Erriez/DualTDA7293PowerAmplifier/schematic/DualTDA7293PowerAmplifier.pdf

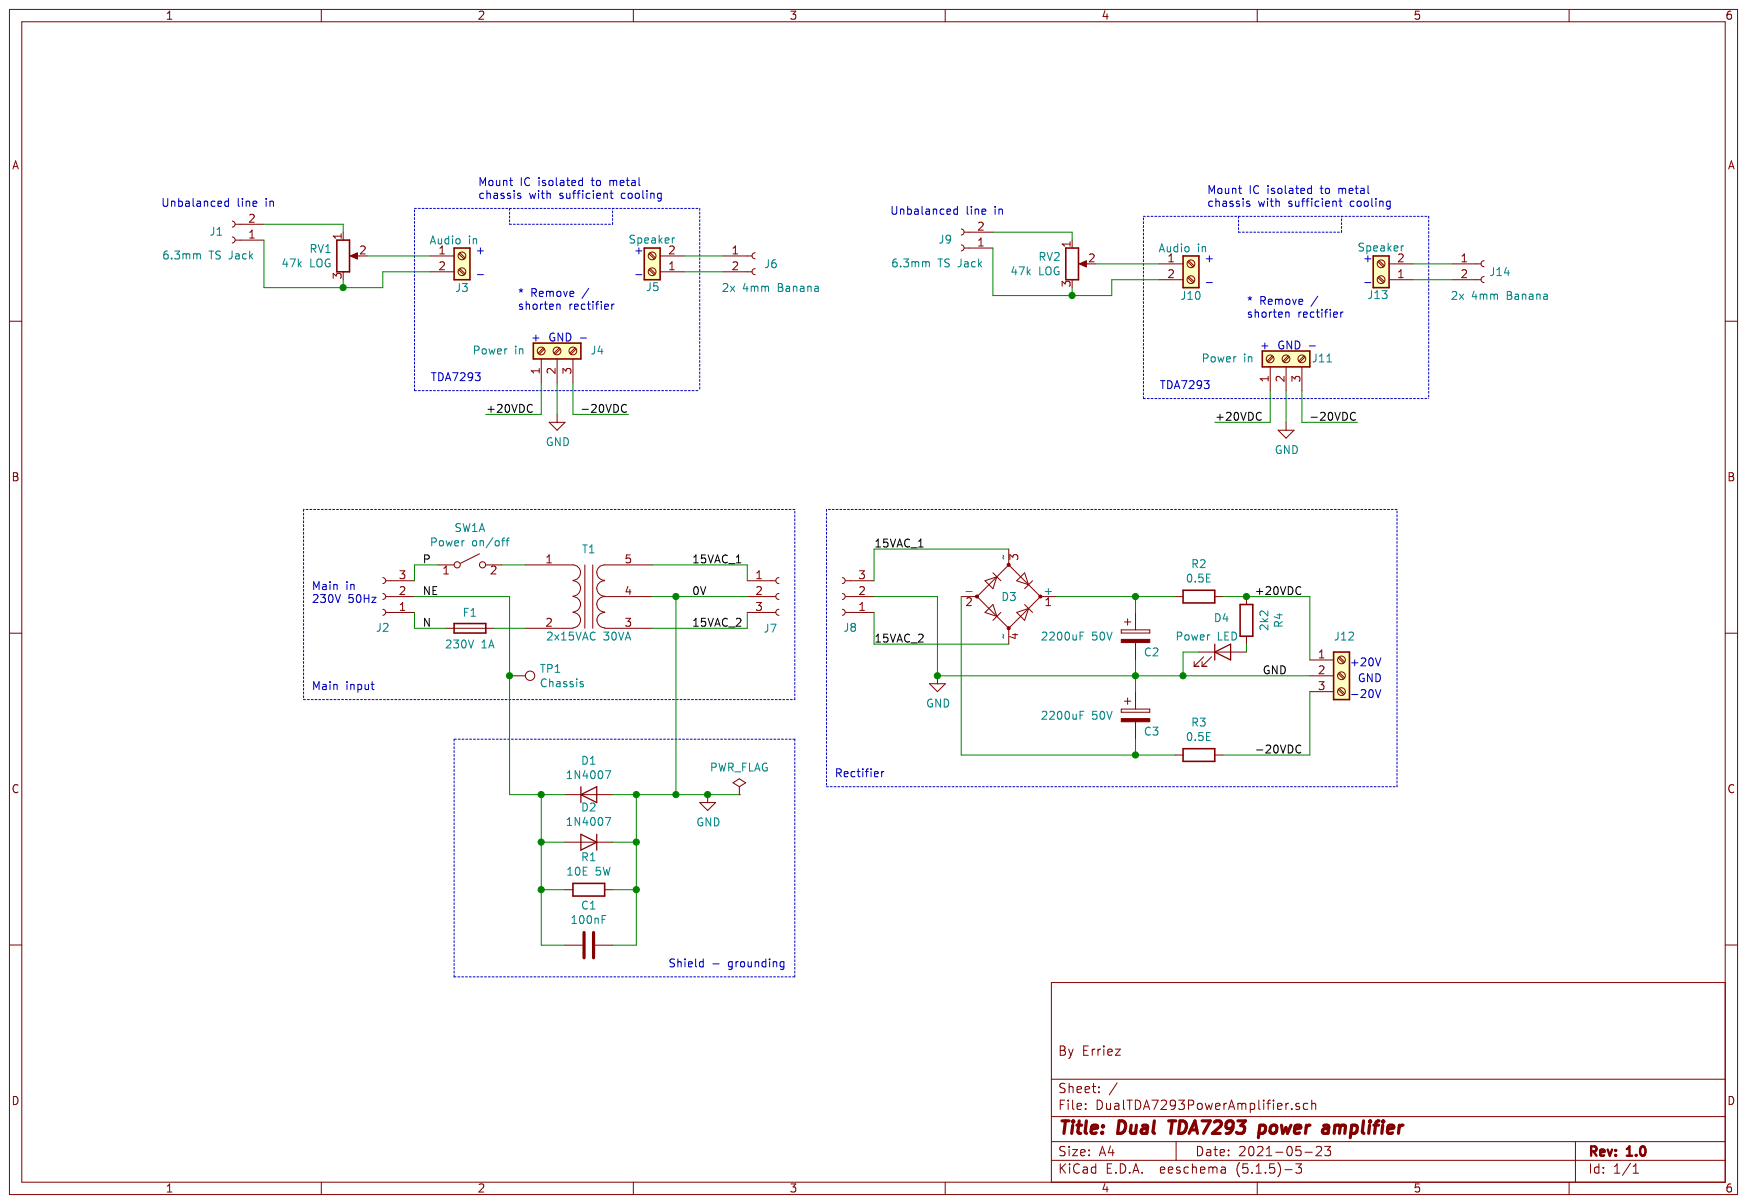
[picture p19: page 1]
