Erriez/DualTDA7293PowerAmplifier/kicad/DualTDA7293PowerAmplifier.sch

## KiCad design kicad/DualTDA7293PowerAmplifier.sch (2021-05-23)

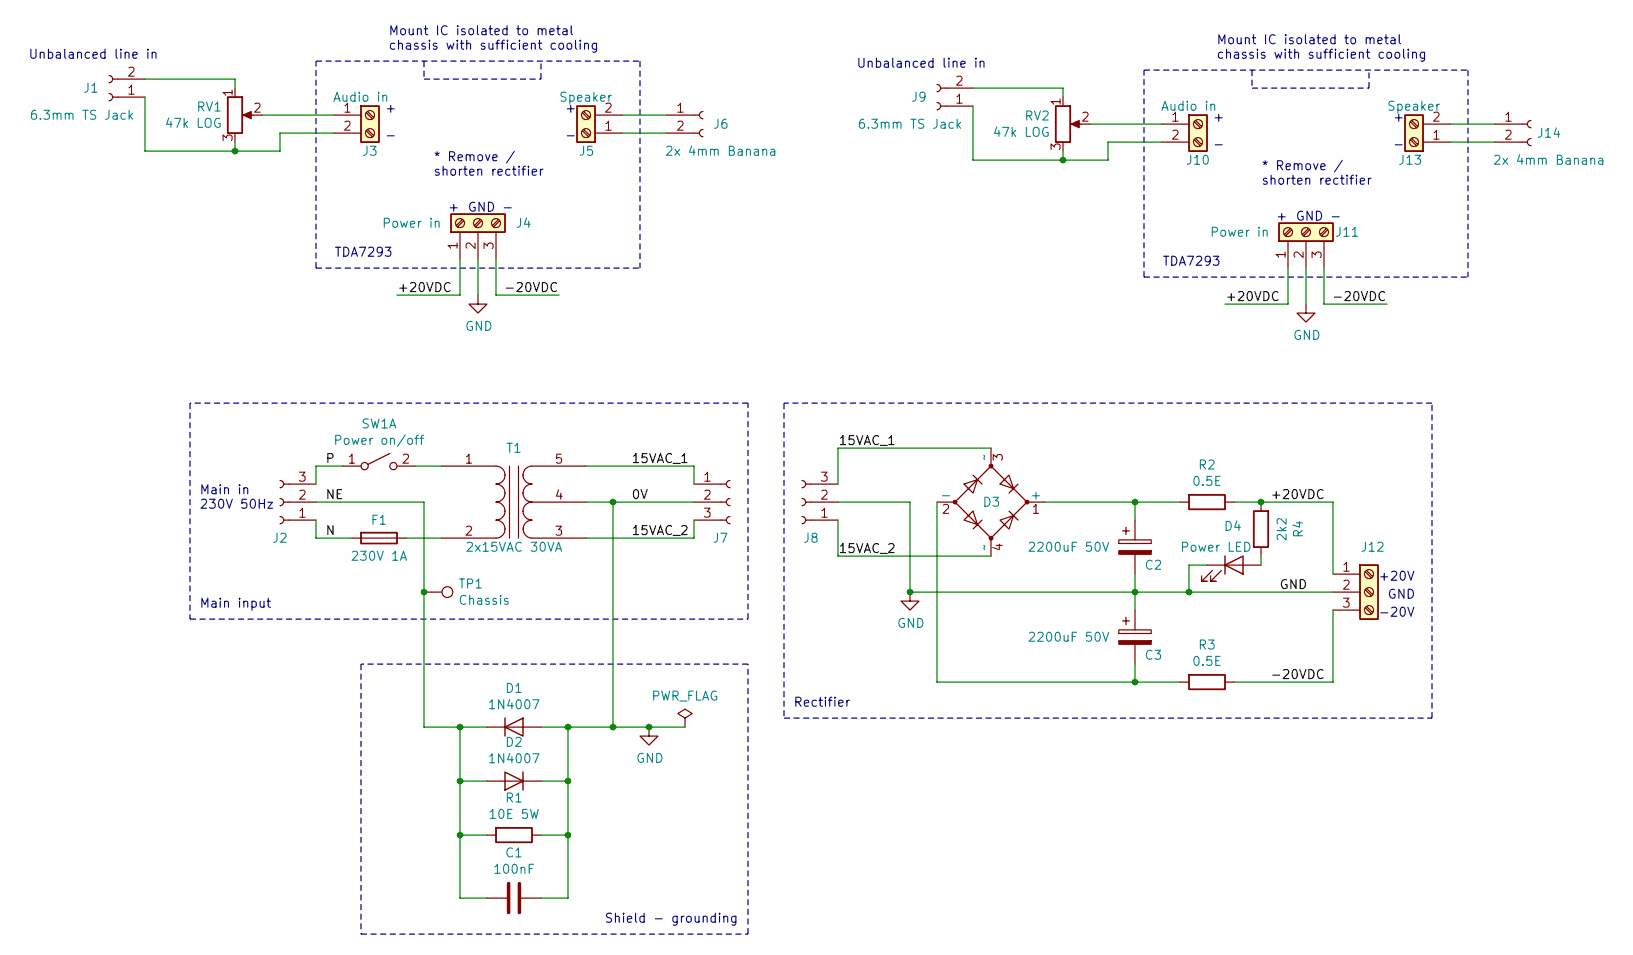
[picture p20: schematic DualTDA7293PowerAmplifier.sch]

Parts:
C1: 100nF
C2, C3: 2200uF 50V
D1, D2: 1N4007; D_DO-41_SOD81_P10.16mm_Horizontal
D3: D_Bridge_+-AA
D4: Power LED
F1: 230V 1A
J1, J9: 6.3mm TS Jack
J2: Main in 230V 50Hz
J3, J10: Audio in
J4, J11: Power in
J5, J13: Speaker
J6, J14: 2x 4mm Banana
J7, J8: Conn_01x03_Female
J12: Screw_Terminal_01x03
R1: 10E 5W
R2, R3: 0.5E
R4: 2k2
RV1, RV2: 47k LOG
SW1: Power on/off
T1: 2x15VAC 30VA
TP1: Chassis

Connections:
15VAC_1: D3.3 (~~), J7.1, J8.3, T1.5 (SB)
15VAC_2: D3.4 (~~), J7.3, J8.1, T1.3 (SA)
+20VDC: J4.1, J11.1, J12.1, R2.1, R4.2
-20VDC: J4.3, J11.3, J12.3, R3.1
GND: C1.1, C2.2, C3.1, D1.2 (A), D2.1 (K), D4.1 (K), J4.2, J7.2, J8.2, J11.2, J12.2, R1.1, T1.4 (SC)
N: F1.2, J2.1
NE: C1.2, D1.1 (K), D2.2 (A), J2.2, R1.2, TP1.1
unnamed: C2.1, D3.1 (+), R2.2
unnamed: C3.2, D3.2 (-), R3.2
unnamed: D4.2 (A), R4.1
unnamed: F1.1, T1.2 (AB)
unnamed: J1.1, J3.2, RV1.3
unnamed: J1.2, RV1.1
unnamed: J3.1, RV1.2
unnamed: J5.1, J6.2
unnamed: J5.2, J6.1
unnamed: J9.2, RV2.1
unnamed: J10.1, RV2.2
unnamed: J9.1, J10.2, RV2.3
unnamed: J13.1, J14.2
unnamed: J13.2, J14.1
unnamed: SW1.2 (B), T1.1 (AA)
P: J2.3, SW1.1 (A)

Notes on the sheet:
Main input
Shield - grounding
Rectifier
+20V
GND
-20V
TDA7293
* Remove / shorten rectifier
Mount IC isolated to metal chassis with sufficient cooling
Unbalanced line in
Main in 230V 50Hz
